Yuqlid/JetsonTK1_Expand_Board/README.md

# JetsonTK1_Expand_Board
2016年12月31日　コミックマーケット91(C91)3日目(Sat)にて頒布した基板のCADデータです．  
設計に使用したCADは[Kicad](http://kicad-pcb.org/)(4.0.4)です．

# 作り方
組立方法は[Wiki](https://github.com/Yuqlid/JetsonTK1_Expand_Board/wiki)を参照してください．

# LICENSE
See LICENSE
