Yuqlid/JetsonTK1_Expand_Board/JetsonTK1_GPIO_connector.kicad_pcb

## KiCad design JetsonTK1_GPIO_connector.kicad_pcb (2016-12-18)

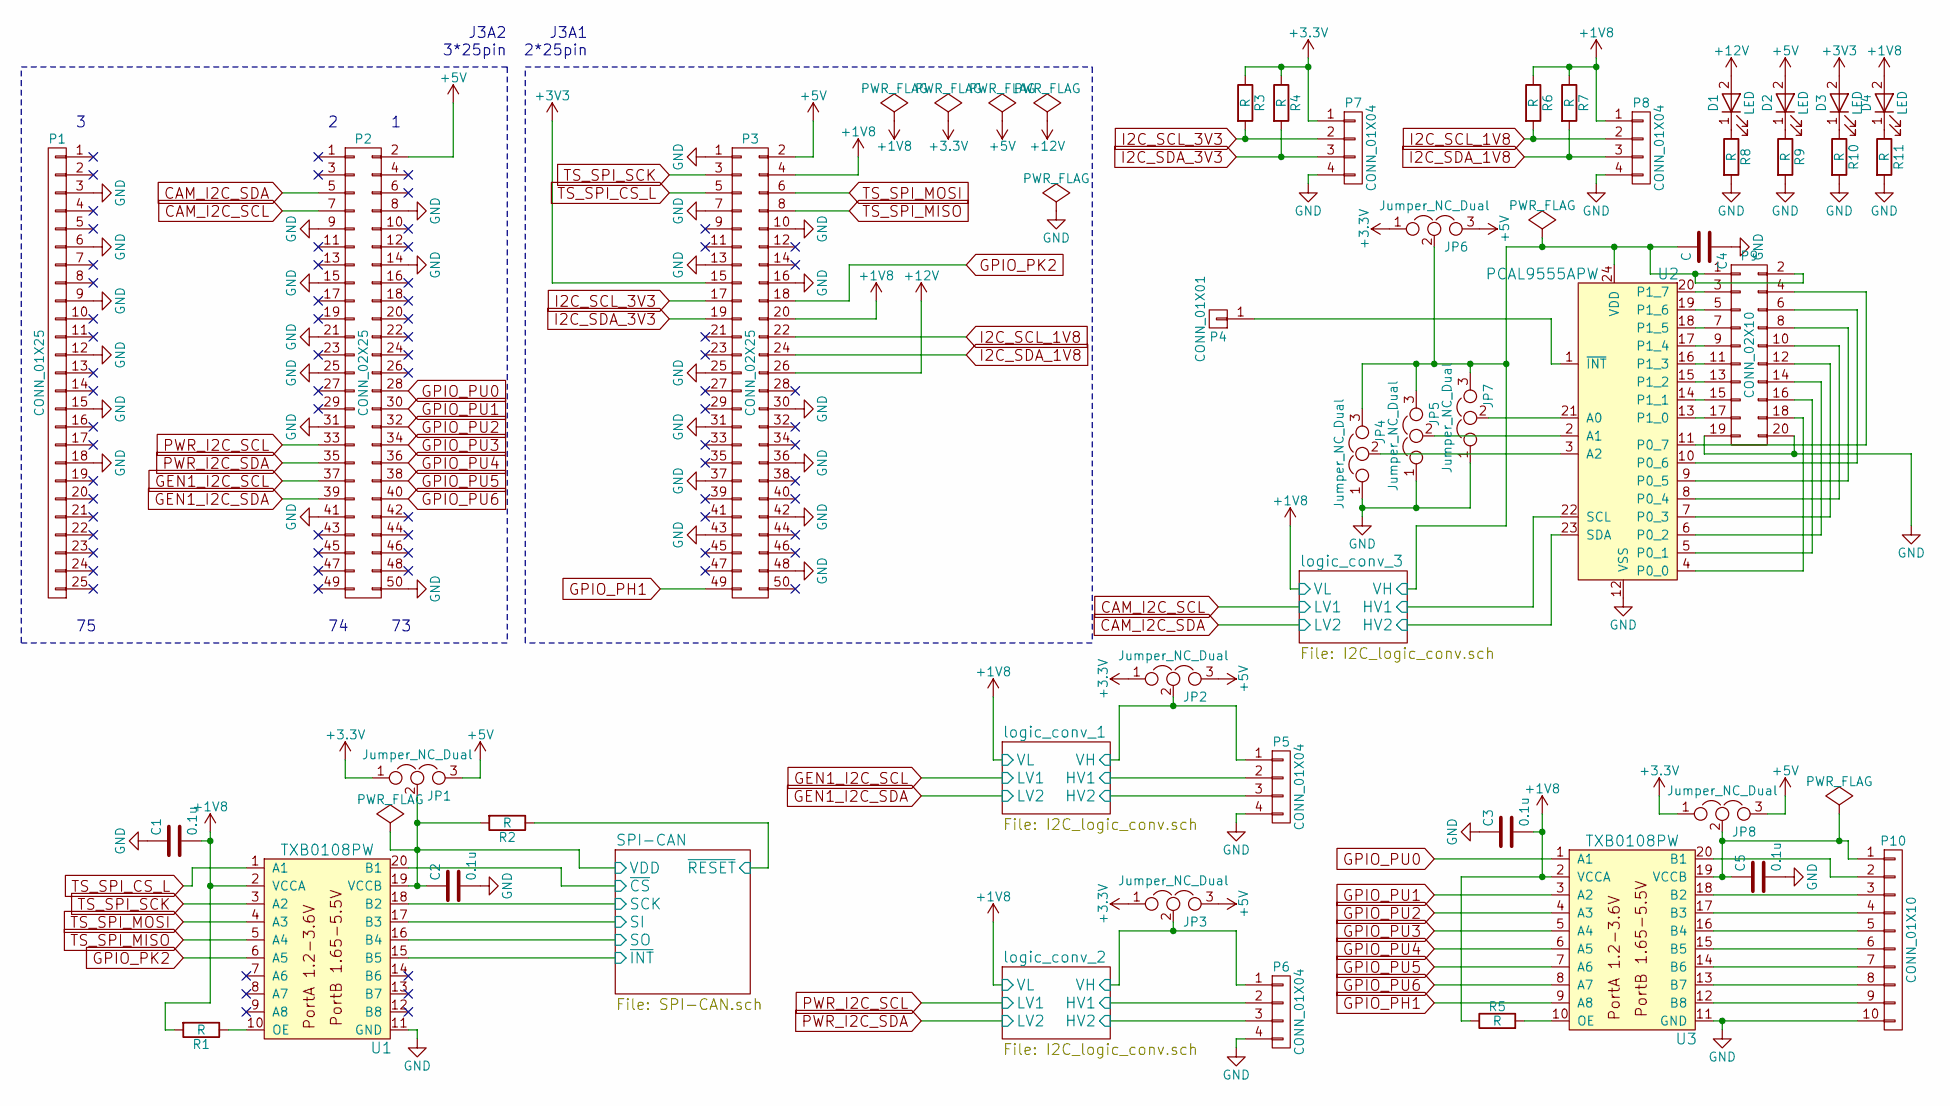
[picture p6: schematic JetsonTK1_GPIO_connector.sch, JetsonTK1_Expand_Board]

Parts:
C1, C2, C3, C5: 0.1u; C_0603
C4: C; C_0603
D1, D2, D3, D4: LED; LED_0603
JP1, JP2, JP3, JP4, JP5, JP6, JP7, JP8: Jumper_NC_Dual; GS3
P1: CONN_01X25; Pin_Header_Straight_1x25_Pitch2.00mm
P2, P3: CONN_02X25; Pin_Header_Straight_2x25_Pitch2.00mm
P4: CONN_01X01; Pin_Header_Straight_1x01
P5, P6, P7, P8: CONN_01X04; JST_XH_B04B-XH-A_04x2.50mm_Straight
P9: CONN_02X10; Multicomp_MC9A12-2034_2x10x2.54mm_Straight
P10: CONN_01X10; JST_XH_B10B-XH-A_10x2.50mm_Straight
R1, R2, R3, R4, R5, R6, R7, R8, R9, R10, R11: R; R_0603
U1, U3: TXB0108PW; TSSOP-20_4.4x6.5mm_Pitch0.65mm
U2: PCAL9555APW; TSSOP-24_4.4x7.8mm_Pitch0.65mm

Connections:
+1V8: C1.2, C3.2, D4.2 (A), P3.4, P3.20, P8.1, R1.2, R5.1, R6.1, R7.1, U1.2 (VCCA), U3.2 (VCCA); also elsewhere on the board
+5V: D2.2 (A), JP1.3, JP2.3, JP3.3, JP6.3, JP8.3, P2.2, P3.2; also elsewhere on the board
+12V: D1.2 (A), P3.26
/SPI-CAN/SCK: U1.18 (B2); also elsewhere on the board
/SPI-CAN/SI: U1.17 (B3); also elsewhere on the board
/SPI-CAN/SO: U1.16 (B4); also elsewhere on the board
/SPI-CAN/VDD: C2.1, JP1.2, R2.2, U1.19 (VCCB); also elsewhere on the board
/SPI-CAN/~CS: U1.20 (B1); also elsewhere on the board
/SPI-CAN/~INT: U1.15 (B5); also elsewhere on the board
/SPI-CAN/~RESET: R2.1; also elsewhere on the board
/logic_conv_1/HV1: P5.2; also elsewhere on the board
/logic_conv_1/HV2: P5.3; also elsewhere on the board
/logic_conv_1/VH: JP2.2, P5.1; also elsewhere on the board
/logic_conv_2/HV1: P6.2; also elsewhere on the board
/logic_conv_2/HV2: P6.3; also elsewhere on the board
/logic_conv_2/VH: JP3.2, P6.1; also elsewhere on the board
/logic_conv_3/HV1: U2.22 (SCL); also elsewhere on the board
/logic_conv_3/HV2: U2.23 (SDA); also elsewhere on the board
/logic_conv_3/VH: C4.2, JP4.3, JP5.3, JP6.2, JP7.3, P9.1, P9.2, U2.24 (VDD); also elsewhere on the board
CAM_I2C_SCL: P2.7; also elsewhere on the board
CAM_I2C_SDA: P2.5; also elsewhere on the board
GEN1_I2C_SCL: P2.37; also elsewhere on the board
GEN1_I2C_SDA: P2.39; also elsewhere on the board
GND: C1.1, C2.2, C3.1, C4.1, C5.2, JP4.1, JP5.1, JP7.1, P1.3, P1.6, P1.9, P1.12, P1.15, P1.18, P2.8, P2.9, P2.14, P2.15, P2.21, P2.25, P2.31, P2.41, P2.50, P3.1, P3.7, P3.10, P3.13, P3.16, P3.25, P3.30, P3.31, P3.36, P3.37, P3.42, P3.43, P3.48, P5.4, P6.4, P7.4, P8.4, P9.19, P9.20, P10.10, R8.2, R9.2, R10.2, R11.2, U1.11 (GND), U2.12 (VSS), U3.11 (GND); also elsewhere on the board
GPIO_PH1: P3.49, U3.9 (A8)
GPIO_PK2: P3.18, U1.6 (A5)
GPIO_PU0: P2.28, U3.1 (A1)
GPIO_PU1: P2.30, U3.3 (A2)
GPIO_PU2: P2.32, U3.4 (A3)
GPIO_PU3: P2.34, U3.5 (A4)
GPIO_PU4: P2.36, U3.6 (A5)
GPIO_PU5: P2.38, U3.7 (A6)
GPIO_PU6: P2.40, U3.8 (A7)
I2C_SCL_1V8: P3.22, P8.2, R6.2
I2C_SCL_3V3: P3.17, P7.2, R3.2
I2C_SDA_1V8: P3.24, P8.3, R7.2
I2C_SDA_3V3: P3.19, P7.3, R4.2
unnamed: C5.1, JP8.2, P10.1, U3.19 (VCCB)
unnamed: D1.1 (K), R8.1
unnamed: D2.1 (K), R9.1
unnamed: D3.1 (K), R10.1
unnamed: D4.1 (K), R11.1
unnamed: JP4.2, U2.3 (A2)
unnamed: JP5.2, U2.2 (A1)
unnamed: JP7.2, U2.21 (A0)
unnamed: P4.1, U2.1 (~INT)
unnamed: P9.3, U2.20 (P1_7)
unnamed: P9.4, U2.11 (P0_7)
unnamed: P9.5, U2.19 (P1_6)
unnamed: P9.6, U2.10 (P0_6)
unnamed: P9.7, U2.18 (P1_5)
unnamed: P9.8, U2.9 (P0_5)
unnamed: P9.9, U2.17 (P1_4)
unnamed: P9.10, U2.8 (P0_4)
unnamed: P9.11, U2.16 (P1_3)
unnamed: P9.12, U2.7 (P0_3)
unnamed: P9.13, U2.15 (P1_2)
unnamed: P9.14, U2.6 (P0_2)
unnamed: P9.15, U2.14 (P1_1)
unnamed: P9.16, U2.5 (P0_1)
unnamed: P9.17, U2.13 (P1_0)
unnamed: P9.18, U2.4 (P0_0)
unnamed: P10.2, U3.20 (B1)
unnamed: P10.3, U3.18 (B2)
unnamed: P10.4, U3.17 (B3)
unnamed: P10.5, U3.16 (B4)
unnamed: P10.6, U3.15 (B5)
unnamed: P10.7, U3.14 (B6)
unnamed: P10.8, U3.13 (B7)
unnamed: P10.9, U3.12 (B8)
unnamed: R1.1, U1.10 (OE)
unnamed: R5.2, U3.10 (OE)
PWR_I2C_SCL: P2.33; also elsewhere on the board
PWR_I2C_SDA: P2.35; also elsewhere on the board
TS_SPI_CS_L: P3.5, U1.1 (A1)
TS_SPI_MISO: P3.8, U1.5 (A4)
TS_SPI_MOSI: P3.6, U1.4 (A3)
TS_SPI_SCK: P3.3, U1.3 (A2)

Notes on the sheet:
J3A1 2*25pin
J3A2 3*25pin

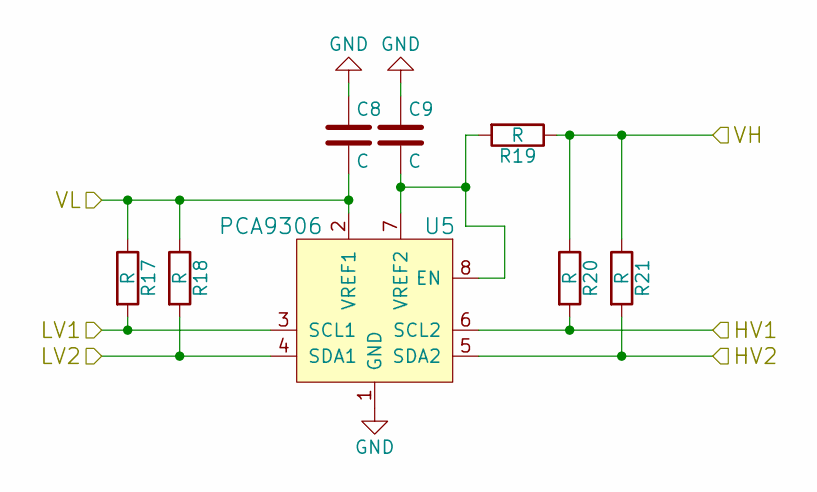
[picture p7: schematic I2C_logic_conv.sch, JetsonTK1_Expand_Board]

Parts:
C6, C7: C; C_0603
R12, R13, R14, R15, R16: R; R_0603
U4: PCA9306; MSOP-8_3x3mm_Pitch0.65mm

Connections:
+1V8: C6.2, R12.1, R13.1, U4.2 (VREF1); also elsewhere on the board
/logic_conv_1/HV1: R15.2, U4.6 (SCL2); also elsewhere on the board
/logic_conv_1/HV2: R16.2, U4.5 (SDA2); also elsewhere on the board
/logic_conv_1/VH: R14.1, R15.1, R16.1; also elsewhere on the board
GEN1_I2C_SCL: R12.2, U4.3 (SCL1); also elsewhere on the board
GEN1_I2C_SDA: R13.2, U4.4 (SDA1); also elsewhere on the board
GND: C6.1, C7.1, U4.1 (GND); also elsewhere on the board
unnamed: C7.2, R14.2, U4.7 (VREF2), U4.8 (EN)

Parts of its further copies:
C8, C9, C15, C16: C; C_0603
R17, R18, R19, R20, R21, R23, R24, R25, R26, R27: R; R_0603
U5, U7: PCA9306; MSOP-8_3x3mm_Pitch0.65mm

Connections of its further copies:
+1V8: C8.2, C15.2, R17.1, R18.1, R23.1, R24.1, U5.2 (VREF1), U7.2 (VREF1); also elsewhere on the board
/logic_conv_2/HV1: R20.2, U5.6 (SCL2); also elsewhere on the board
/logic_conv_2/HV2: R21.2, U5.5 (SDA2); also elsewhere on the board
/logic_conv_2/VH: R19.1, R20.1, R21.1; also elsewhere on the board
/logic_conv_3/HV1: R26.2, U7.6 (SCL2); also elsewhere on the board
/logic_conv_3/HV2: R27.2, U7.5 (SDA2); also elsewhere on the board
/logic_conv_3/VH: R25.1, R26.1, R27.1; also elsewhere on the board
CAM_I2C_SCL: R23.2, U7.3 (SCL1); also elsewhere on the board
CAM_I2C_SDA: R24.2, U7.4 (SDA1); also elsewhere on the board
GND: C8.1, C9.1, C15.1, C16.1, U5.1 (GND), U7.1 (GND); also elsewhere on the board
unnamed: C9.2, R19.2, U5.7 (VREF2), U5.8 (EN)
unnamed: C16.2, R25.2, U7.7 (VREF2), U7.8 (EN)
PWR_I2C_SCL: R17.2, U5.3 (SCL1); also elsewhere on the board
PWR_I2C_SDA: R18.2, U5.4 (SDA1); also elsewhere on the board

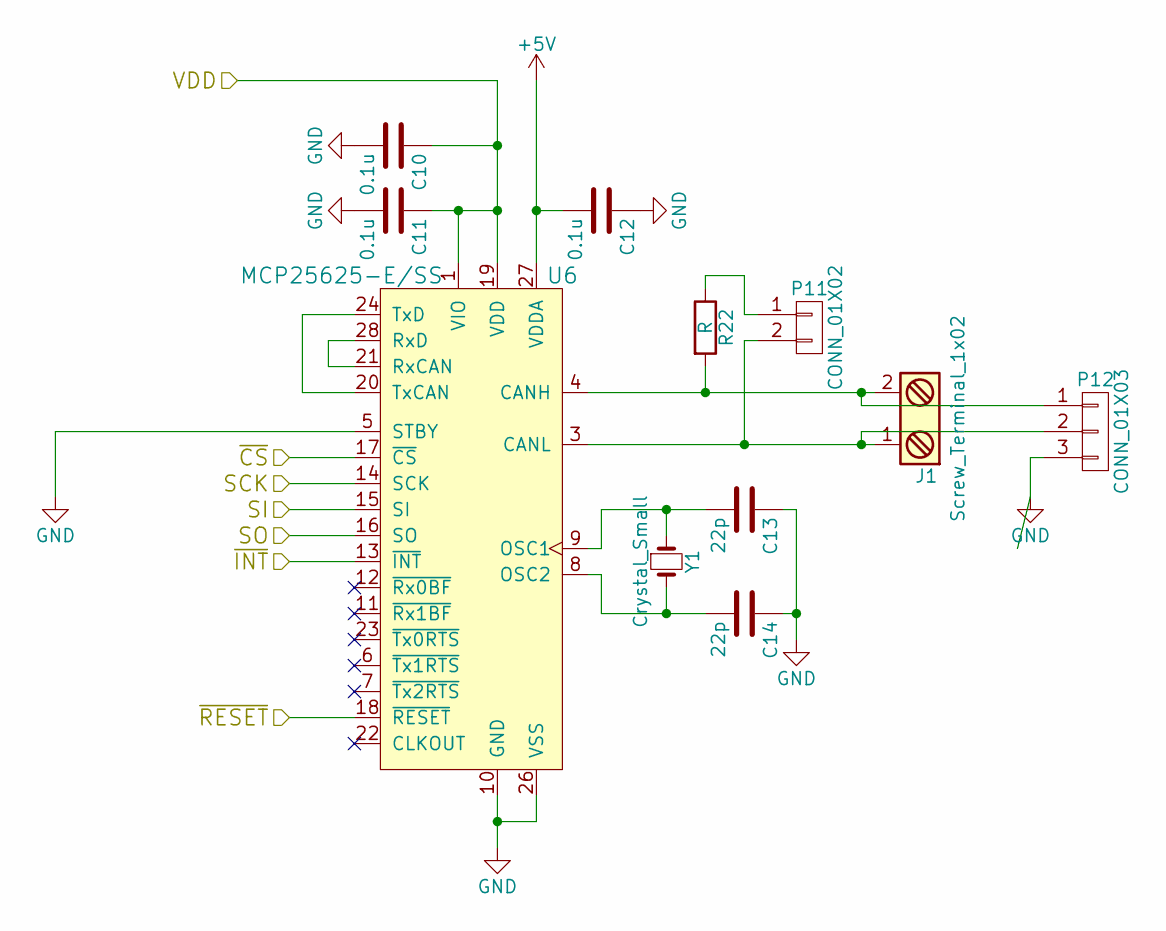
[picture p8: schematic SPI-CAN.sch, JetsonTK1_Expand_Board]

Parts:
C10, C11, C12: 0.1u; C_0603
C13, C14: 22p; C_0603
J1: Screw_Terminal_1x02; TerminalBlock_Pheonix_MKDS1.5-2pol
P11: CONN_01X02; Pin_Header_Straight_1x02
P12: CONN_01X03; Pin_Header_Straight_1x03
R22: R; R_0603
U6: MCP25625-E/SS; SSOP-28_5.3x10.2mm_Pitch0.65mm
Y1: Crystal_Small; Crystal_HC49-U_Vertical

Connections:
+5V: C12.2, U6.27 (VDDA); also elsewhere on the board
/SPI-CAN/SCK: U6.14 (SCK); also elsewhere on the board
/SPI-CAN/SI: U6.15 (SI); also elsewhere on the board
/SPI-CAN/SO: U6.16 (SO); also elsewhere on the board
/SPI-CAN/VDD: C10.1, C11.1, U6.1 (VIO), U6.19 (VDD); also elsewhere on the board
/SPI-CAN/~CS: U6.17 (~CS); also elsewhere on the board
/SPI-CAN/~INT: U6.13 (~INT); also elsewhere on the board
/SPI-CAN/~RESET: U6.18 (~RESET); also elsewhere on the board
GND: C10.2, C11.2, C12.1, C13.1, C14.1, P12.3, U6.5 (STBY), U6.10 (GND), U6.26 (VSS); also elsewhere on the board
unnamed: C13.2, U6.9 (OSC1), Y1.1
unnamed: C14.2, U6.8 (OSC2), Y1.2
unnamed: J1.1, P11.2, P12.2, U6.3 (CANL)
unnamed: J1.2, P12.1, R22.2, U6.4 (CANH)
unnamed: P11.1, R22.1
unnamed: U6.20 (TxCAN), U6.24 (TxD)
unnamed: U6.21 (RxCAN), U6.28 (RxD)

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
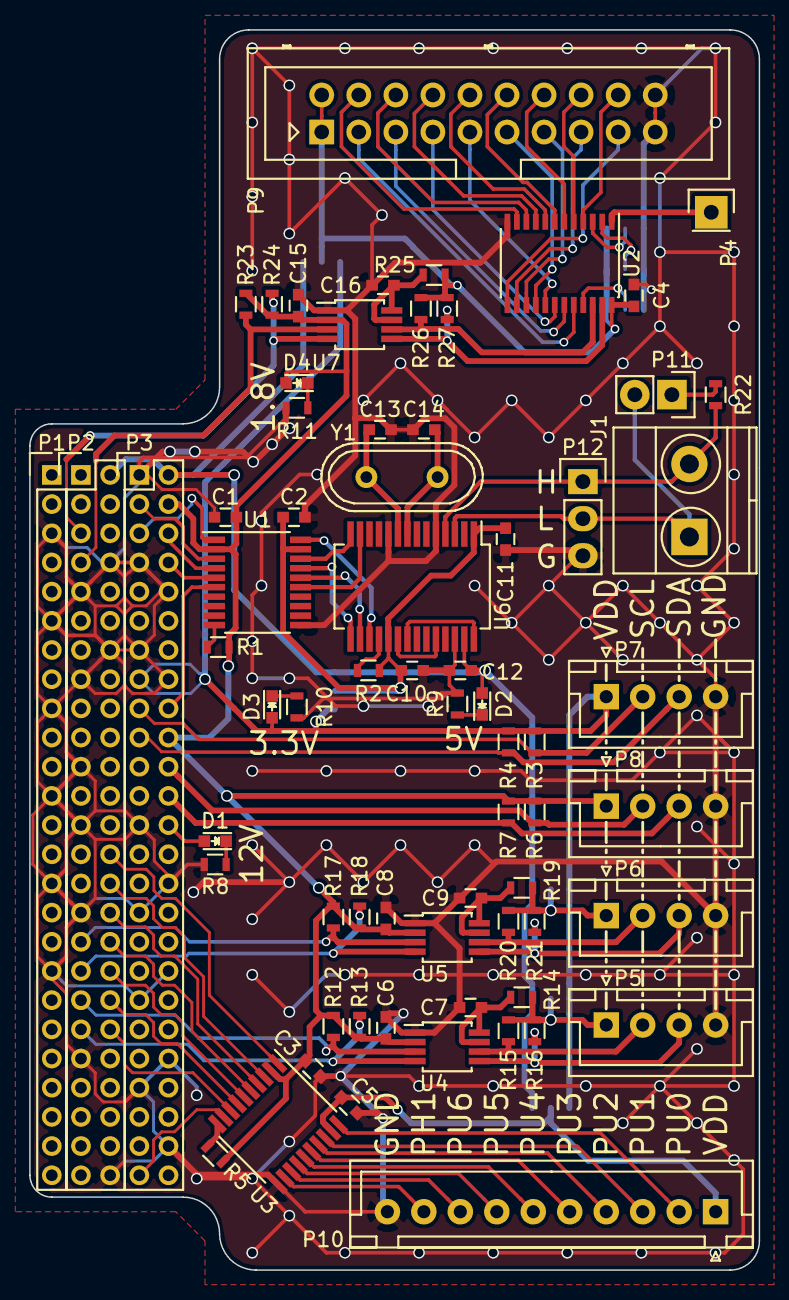
[picture p9: board JetsonTK1_GPIO_connector.kicad_pcb from above]

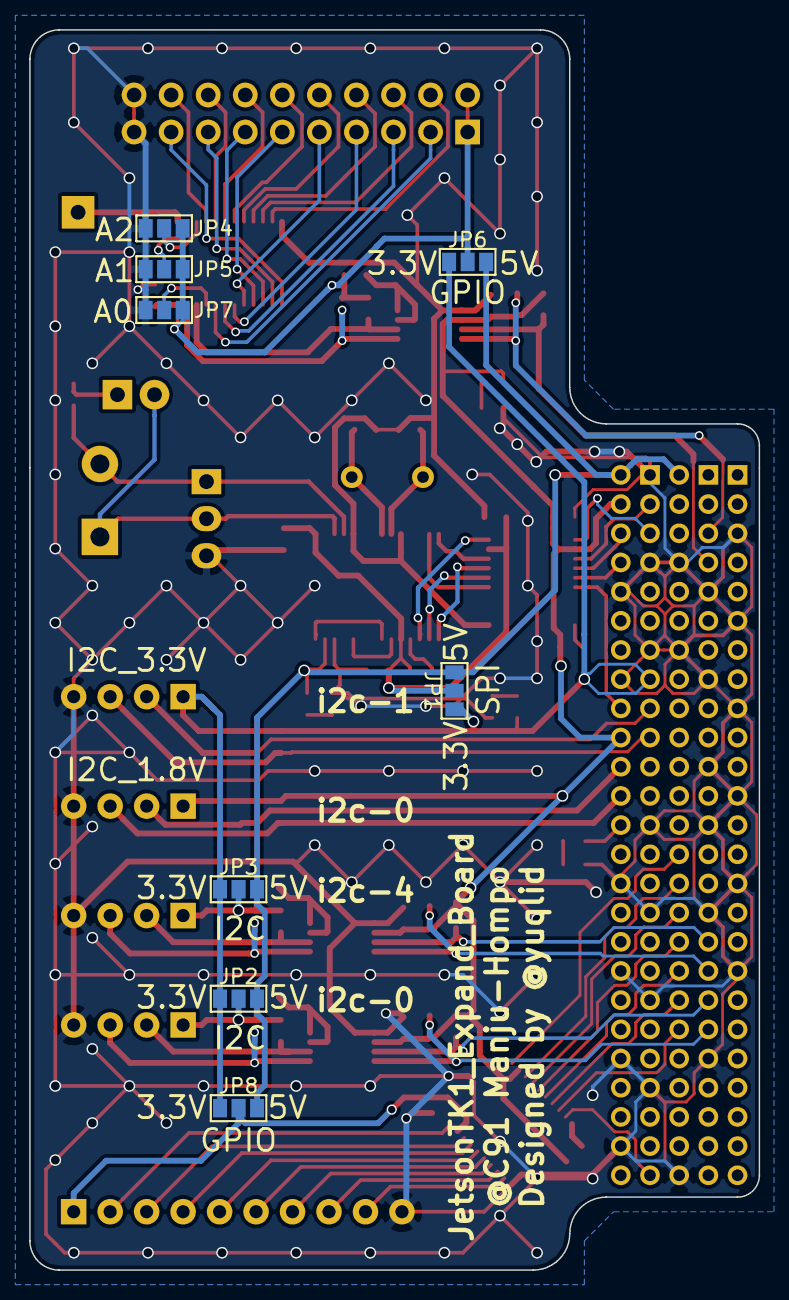
[picture p10: board JetsonTK1_GPIO_connector.kicad_pcb from below]

Board: 2 copper layers, 50.0 x 85.0 mm, 76 parts (8 on the bottom side), 89 nets.
