Yuqlid/JetsonTK1_Expand_Board/(commit log)

2016-11-02 GPIOとi2cを追加
2016-11-25 シート追加
    [I2C_logic_conv.sch, JetsonTK1_GPIO_connector.sch, SPI-CAN.sch]
2016-11-26 IC追加
    [I2C_logic_conv.sch, JetsonTK1_GPIO_connector.sch, SPI-CAN.sch]
2016-11-26 アートワーク編集
    [JetsonTK1_GPIO_connector.sch]
2016-11-27 アートワーク開始
    [I2C_logic_conv.sch, JetsonTK1_GPIO_connector.kicad_pcb, JetsonTK1_GPIO_connector.sch, SPI-CAN.sch]
2016-11-30 LED以外接続完了
    [JetsonTK1_GPIO_connector.kicad_pcb]
2016-11-30 ver1.0完成，これでElecrow発注
    [I2C_logic_conv.sch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]
2016-12-18 図面にタイトルを追加
    [I2C_logic_conv.sch, JetsonTK1_GPIO_connector.sch, SPI-CAN.sch]
2016-12-18 名称変更，再アノテーション
    [I2C_logic_conv.sch, JetsonTK1_GPIO_connector.sch, SPI-CAN.sch]
2016-12-18 via追加
    [JetsonTK1_GPIO_connector.kicad_pcb]
2016-12-18 コミックマーケット91用基板ガーバ出力
    [JetsonTK1_GPIO_connector-B.Cu.gbl, JetsonTK1_GPIO_connector-B.Mask.gbs, JetsonTK1_GPIO_connector-B.SilkS.gbo, JetsonTK1_GPIO_connector-Edge.Cuts.gm1, JetsonTK1_GPIO_connector-F.Cu.gtl, JetsonTK1_GPIO_connector-F.Mask.gts, JetsonTK1_GPIO_connector-F.SilkS.gto, JetsonTK1_GPIO_connector.drl]
2016-12-29 部品に定数を追加
    [I2C_logic_conv.sch, JetsonTK1_GPIO_connector.sch, SPI-CAN.sch]
2016-12-30 BOMを追加
    [JetsonTK1_GPIO_connector.csv]
2017-07-01 図面をPDFに出力
